3KUdelta/ESP8266-World-Clock/(commit log)

2020-11-18 added hint where to get 5v from
2020-12-28 Bug fix, take RTC stored values if there is no WiFi
    [ESP8266_WorldClock.ino]
2021-02-12 fixed problem with NTP misreadings
    [ESP8266_WorldClock.ino]
2021-03-04 fixed time correction logic (NTP time always corrects RTC if differences)
    [ESP8266_WorldClock.ino]
2021-03-18 Bugfix: automatic adjustment of time
    [ESP8266_WorldClock.ino]
